Yi-lne/Embedded-project--DCDC_BUCK_and_BOOST/PCB/原理图与PCB/PCB_DCDC升降压_2026-11-07.png

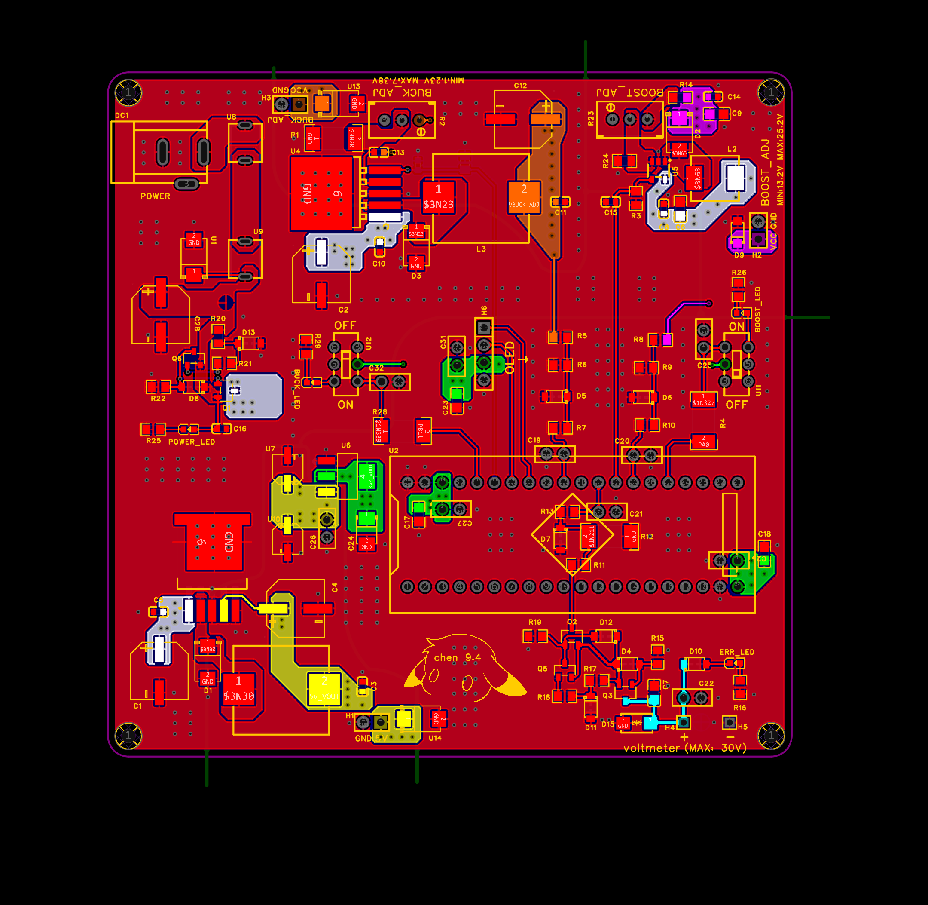
PCB/原理图与PCB/PCB_DCDC升降压_2026-11-07.png
