Yi-lne/Embedded-project--DCDC_BUCK_and_BOOST/PCB/原理图与PCB/SCH_Schematic1_1-升降压模块_2026-11-07.png

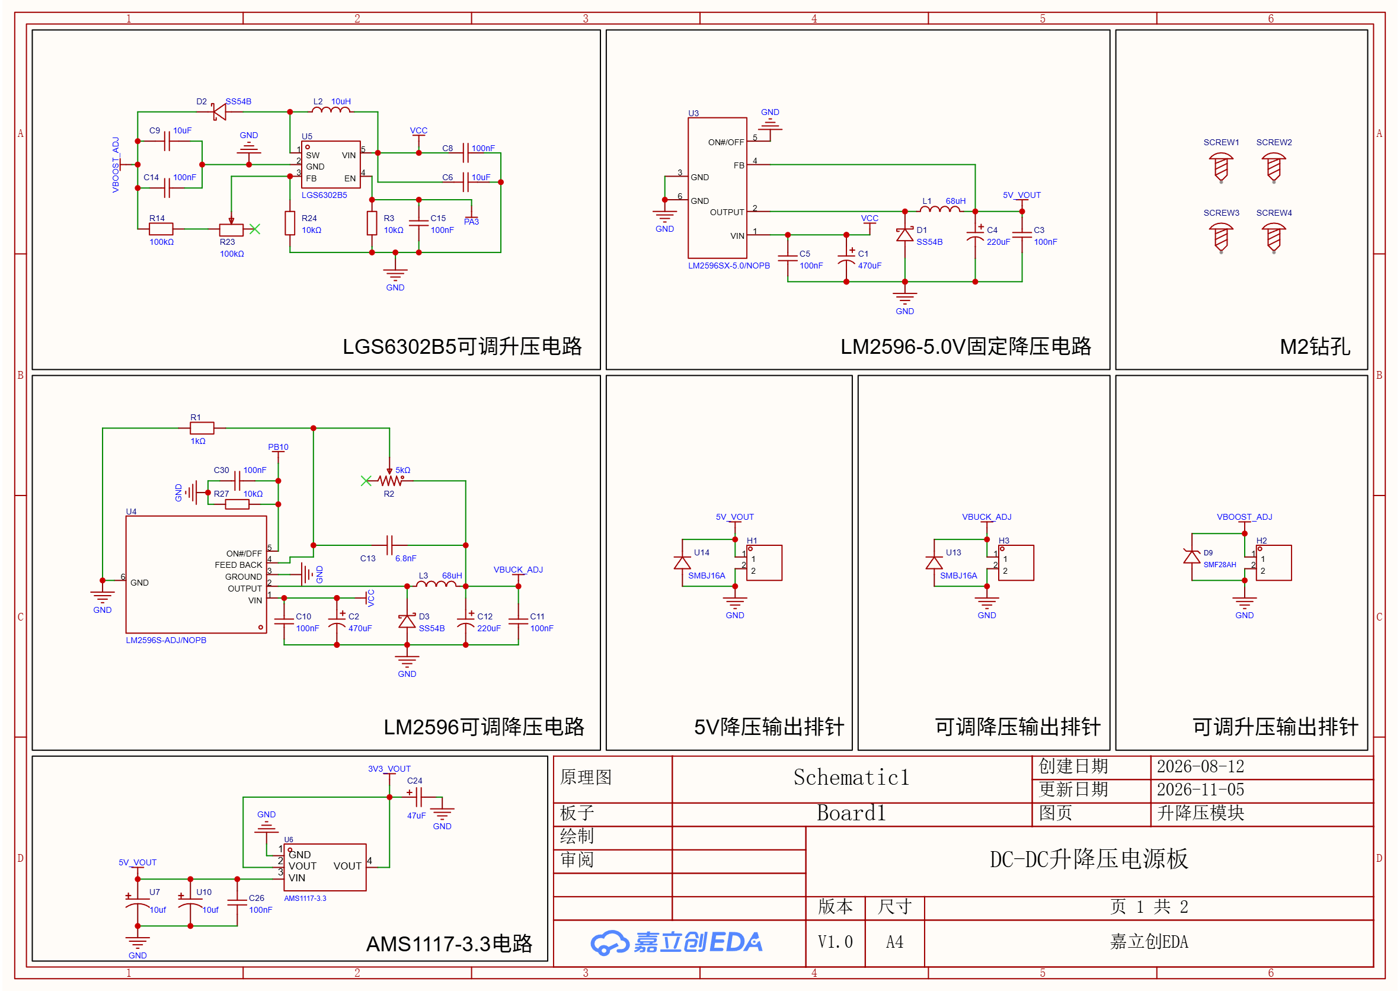
PCB/原理图与PCB/SCH_Schematic1_1-升降压模块_2026-11-07.png
