Yi-lne/Embedded-project--DCDC_BUCK_and_BOOST/program/Core/Src/main.c

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
/* Includes ------------------------------------------------------------------*/
#include "main.h"
#include "adc.h"
#include "dma.h"
#include "tim.h"
#include "gpio.h"

/* USER CODE BEGIN Includes */
#include "oled.h"
#include "switches.h"
#include "oled_show.h"
/* USER CODE END Includes */


/* USER CODE BEGIN PV */
//adc_data[0]: buck_adj, adc_data[1]: boost_adj, adc_data[2]: voltmeter
volatile uint16_t adc_data[3] = {0};
/* USER CODE END PV */

void SystemClock_Config(void);
/**
  * @brief  The application entry point.
  * @retval int
  */
int main(void)
{

  /* MCU Configuration--------------------------------------------------------*/

  /* Reset of all peripherals, Initializes the Flash interface and the Systick. */
  HAL_Init();

  /* Configure the system clock */
  SystemClock_Config();

  /* Initialize all configured peripherals */
  MX_GPIO_Init();
  MX_DMA_Init();
  MX_TIM3_Init();
  MX_TIM2_Init();
  MX_ADC1_Init();
  /* USER CODE BEGIN 2 */
  HAL_ADCEx_Calibration_Start(&hadc1);
  OLED_Init();
  OLED_ShowString(1, 1, "DCDC_BUCK_BOOST");
  OLED_ShowString(2, 1, "BUCK_ADJ :");
  OLED_ShowString(3, 1, "BOOST_ADJ:");
  OLED_ShowString(4, 1, "Voltmeter:");

  HAL_ADC_Start_DMA(&hadc1, (uint32_t*)adc_data, 3);
  /* 不使用 DMA 传输完成回调，关闭 TC 中断，避免 48kHz 中断持续打断软件 I2C */
  __HAL_DMA_DISABLE_IT(hadc1.DMA_Handle, DMA_IT_TC);

  switches_state_init();
  /* USER CODE END 2 */

  /* Infinite loop */
  /* USER CODE BEGIN WHILE */
  uint32_t last_refresh = HAL_GetTick();

  while (1)
  {
      if ((HAL_GetTick() - last_refresh) >= 100U)
      {
          last_refresh += 100U;
          //电压转换
          voltage_conversion();
          //电压显示
          voltage_display();
      }

      __WFI();

    /* USER CODE END WHILE */

    /* USER CODE BEGIN 3 */
  }
  /* USER CODE END 3 */
}

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
