Yi-lne/Embedded-project--DCDC_BUCK_and_BOOST/program/Core/Inc/main.h

#define BOOST_ADJ_SWITCH_Pin GPIO_PIN_0
#define BOOST_ADJ_SWITCH_GPIO_Port GPIOA
#define BOOST_ADJ_SWITCH_EXTI_IRQn EXTI0_IRQn
#define BOOST_ADJ_ADC_Pin GPIO_PIN_2
#define BOOST_ADJ_ADC_GPIO_Port GPIOA
#define BOOST_ADJ_DRIVER_Pin GPIO_PIN_3
#define BOOST_ADJ_DRIVER_GPIO_Port GPIOA
#define VOLTMETER_ADC_Pin GPIO_PIN_4
#define VOLTMETER_ADC_GPIO_Port GPIOA
#define BUCK_ADJ_ADC_Pin GPIO_PIN_6
#define BUCK_ADJ_ADC_GPIO_Port GPIOA
#define BUCK_ADJ_DRIVER_Pin GPIO_PIN_10
#define BUCK_ADJ_DRIVER_GPIO_Port GPIOB
#define BUCK_ADJ_SWITCH_Pin GPIO_PIN_11
#define BUCK_ADJ_SWITCH_GPIO_Port GPIOB
#define BUCK_ADJ_SWITCH_EXTI_IRQn EXTI15_10_IRQn
