Yi-lne/Embedded-project--DCDC_BUCK_and_BOOST/program/Hardware/oled/oled.c

#include "stm32f1xx_hal.h"
#include "OLED_Font.h"

/* 引脚配置：替换为HAL库的引脚操作宏 */
#define OLED_W_SCL(x)    HAL_GPIO_WritePin(GPIOB, GPIO_PIN_1, (GPIO_PinState)x)
#define OLED_W_SDA(x)    HAL_GPIO_WritePin(GPIOB, GPIO_PIN_0, (GPIO_PinState)x)

/* 软件 I2C 半周期延时。SSD1306 上限 400kHz，半周期约 1.25us。
 * -O0 下 12 次空循环约 1us 左右；用示波器看 PB1(SCL)，过快/过慢时调整该值。 */
#define OLED_I2C_DELAY_LOOPS    12U

static void OLED_I2C_Delay(void)
{
    for (volatile uint32_t i = 0; i < OLED_I2C_DELAY_LOOPS; i++)
    {
        __NOP();
    }
}

/* 前置声明：OLED_WriteDataBuffer 重试时需要重新设置光标 */
void OLED_SetCursor(uint8_t Y, uint8_t X);

/* 引脚初始化：适配HAL库GPIO初始化 */
void OLED_I2C_Init(void)
{
    GPIO_InitTypeDef GPIO_InitStructure = {0};

    /* 使能GPIOB时钟（HAL库方式） */
    __HAL_RCC_GPIOB_CLK_ENABLE();

    /* 配置PB8、PB9为开漏输出 */
    GPIO_InitStructure.Pin = GPIO_PIN_1 | GPIO_PIN_0;
    GPIO_InitStructure.Mode = GPIO_MODE_OUTPUT_OD;  // 开漏输出（与标准库一致）
    GPIO_InitStructure.Pull = GPIO_PULLUP;          // 内部弱上拉，外部模块还有 4.7k 上拉
    GPIO_InitStructure.Speed = GPIO_SPEED_FREQ_HIGH;// 高速（对应50MHz）
    HAL_GPIO_Init(GPIOB, &GPIO_InitStructure);

    /* 初始电平置高 */
    OLED_W_SCL(1);
    OLED_W_SDA(1);
}

/**
  * @brief  I2C开始
  * @param  无
  * @retval 无
  */
void OLED_I2C_Start(void)
{
    OLED_W_SDA(1);
    OLED_I2C_Delay();
    OLED_W_SCL(1);
    OLED_I2C_Delay();
    OLED_W_SDA(0);
    OLED_I2C_Delay();
    OLED_W_SCL(0);
    OLED_I2C_Delay();
}

/**
  * @brief  I2C停止
  * @param  无
  * @retval 无
  */
void OLED_I2C_Stop(void)
{
    OLED_W_SDA(0);
    OLED_I2C_Delay();
    OLED_W_SCL(1);
    OLED_I2C_Delay();
    OLED_W_SDA(1);
    OLED_I2C_Delay();
}

/**
  * @brief  I2C发送一个字节并读取应答
  * @param  Byte 要发送的一个字节
  * @retval 1：收到 ACK；0：收到 NACK
  */
uint8_t OLED_I2C_SendByte(uint8_t Byte)
{
    uint8_t i;
    uint8_t ack;

    for (i = 0; i < 8; i++)
    {
        OLED_W_SDA(!!(Byte & (0x80 >> i)));
        OLED_I2C_Delay();
        OLED_W_SCL(1);
        OLED_I2C_Delay();
        OLED_W_SCL(0);
        OLED_I2C_Delay();
    }

    /* 第 9 个时钟：释放 SDA，读取从机应答 */
    OLED_W_SDA(1);
    OLED_I2C_Delay();
    OLED_W_SCL(1);
    OLED_I2C_Delay();

    ack = (HAL_GPIO_ReadPin(GPIOB, GPIO_PIN_0) == GPIO_PIN_RESET) ? 1U : 0U;

    OLED_W_SCL(0);
    OLED_I2C_Delay();

    return ack;
}

/**
  * @brief  OLED写命令
  * @param  Command 要写入的命令
  * @retval 无
  */
void OLED_WriteCommand(uint8_t Command)
{
    uint8_t retry;

    for (retry = 0; retry < 3U; retry++)
    {
        OLED_I2C_Start();
        if (OLED_I2C_SendByte(0x78) &&       //从机地址
            OLED_I2C_SendByte(0x00) &&       //写命令
            OLED_I2C_SendByte(Command))
        {
            OLED_I2C_Stop();
            return;
        }
        OLED_I2C_Stop();
        OLED_I2C_Delay();
    }
}

/**
  * @brief  OLED写数据
  * @param  Data 要写入的数据
  * @retval 无
  */
void OLED_WriteData(uint8_t Data)
{
    uint8_t retry;

    for (retry = 0; retry < 3U; retry++)
    {
        OLED_I2C_Start();
        if (OLED_I2C_SendByte(0x78) &&       //从机地址
            OLED_I2C_SendByte(0x40) &&       //写数据
            OLED_I2C_SendByte(Data))
        {
            OLED_I2C_Stop();
            return;
        }
        OLED_I2C_Stop();
        OLED_I2C_Delay();
    }
}

/**
  * @brief  OLED连续写多个数据字节（一次 Start/Stop，减少事务开销）
  * @param  Y 页地址，范围：0~7
  * @param  X 列地址，范围：0~127
  * @param  Data 数据缓冲区
  * @param  Length 数据长度
  * @retval 无
  * @note   每次重试都会重新设置光标，避免半包写入后光标错位
  */
static void OLED_WriteDataBuffer(uint8_t Y, uint8_t X, const uint8_t *Data, uint8_t Length)
{
    uint8_t retry;

    for (retry = 0; retry < 3U; retry++)
    {
        uint8_t i;
        uint8_t ok = 1U;

        OLED_SetCursor(Y, X);
        OLED_I2C_Start();
        if (!OLED_I2C_SendByte(0x78) || !OLED_I2C_SendByte(0x40))
        {
            ok = 0U;
        }
        else
        {
            for (i = 0; i < Length; i++)
            {
                if (!OLED_I2C_SendByte(Data[i]))
                {
                    ok = 0U;
                    break;
                }
            }
        }
        OLED_I2C_Stop();

        if (ok)
        {
            return;
        }
        OLED_I2C_Delay();
    }
}

/**
  * @brief  OLED设置光标位置
  * @param  Y 以左上角为原点，向下方向的坐标，范围：0~7
  * @param  X 以左上角为原点，向右方向的坐标，范围：0~127
  * @retval 无
  */
void OLED_SetCursor(uint8_t Y, uint8_t X)
{
    OLED_WriteCommand(0xB0 | Y);                    //设置Y位置
    OLED_WriteCommand(0x10 | ((X & 0xF0) >> 4));    //设置X位置高4位
    OLED_WriteCommand(0x00 | (X & 0x0F));            //设置X位置低4位
}

/**
  * @brief  OLED清屏
  * @param  无
  * @retval 无
  */
void OLED_Clear(void)
{
    uint8_t i, j;
    uint8_t zero[16] = {0};

    for (j = 0; j < 8; j++)
    {
        for (i = 0; i < 8; i++)
        {
            OLED_WriteDataBuffer(j, (uint8_t)(i * 16U), zero, 16U);
        }
    }
}

/**
  * @brief  OLED显示一个字符
  * @param  Line 行位置，范围：1~4
  * @param  Column 列位置，范围：1~16
  * @param  Char 要显示的一个字符，范围：ASCII可见字符
  * @retval 无
  */
void OLED_ShowChar(uint8_t Line, uint8_t Column, uint8_t Char)
{
    uint8_t i;
    uint8_t buf[8];

    for (i = 0; i < 8; i++)
    {
        buf[i] = OLED_F8x16[Char - ' '][i];                  //上半部分内容
    }
    OLED_WriteDataBuffer((uint8_t)((Line - 1) * 2), (uint8_t)((Column - 1) * 8), buf, 8U);

    for (i = 0; i < 8; i++)
    {
        buf[i] = OLED_F8x16[Char - ' '][i + 8];              //下半部分内容
    }
    OLED_WriteDataBuffer((uint8_t)((Line - 1) * 2 + 1), (uint8_t)((Column - 1) * 8), buf, 8U);
}

/**
  * @brief  OLED显示字符串
  * @param  Line 起始行位置，范围：1~4
  * @param  Column 起始列位置，范围：1~16
  * @param  String 要显示的字符串，范围：ASCII可见字符
  * @retval 无
  */
void OLED_ShowString(uint8_t Line, uint8_t Column, const char String[])
{
    uint8_t i;
    for (i = 0; String[i] != '\0'; i++)
    {
        OLED_ShowChar(Line, Column + i, (uint8_t)String[i]);
    }
}

/**
  * @brief  OLED次方函数
  * @retval 返回值等于X的Y次方
  */
uint32_t OLED_Pow(uint32_t X, uint32_t Y)
{
    uint32_t Result = 1;
    while (Y--)
    {
        Result *= X;
    }
    return Result;
}

/**
  * @brief  OLED显示数字（十进制，正数）
  * @param  Line 起始行位置，范围：1~4
  * @param  Column 起始列位置，范围：1~16
  * @param  Number 要显示的数字，范围：0~4294967295
  * @param  Length 要显示数字的长度，范围：1~10
  * @retval 无
  */
void OLED_ShowNum(uint8_t Line, uint8_t Column, uint32_t Number, uint8_t Length)
{
    uint8_t i;
    for (i = 0; i < Length; i++)
    {
        OLED_ShowChar(Line, Column + i, Number / OLED_Pow(10, Length - i - 1) % 10 + '0');
    }
}

/**
  * @brief  OLED显示数字（十进制，带符号数）
  * @param  Line 起始行位置，范围：1~4
  * @param  Column 起始列位置，范围：1~16
  * @param  Number 要显示的数字，范围：-2147483648~2147483647
  * @param  Length 要显示数字的长度，范围：1~10
  * @retval 无
  */
void OLED_ShowSignedNum(uint8_t Line, uint8_t Column, int32_t Number, uint8_t Length)
{
    uint8_t i;
    uint32_t Number1;
    if (Number >= 0)
    {
        OLED_ShowChar(Line, Column, '+');
        Number1 = Number;
    }
    else
    {
        OLED_ShowChar(Line, Column, '-');
        Number1 = -Number;
    }
    for (i = 0; i < Length; i++)
    {
        OLED_ShowChar(Line, Column + i + 1, Number1 / OLED_Pow(10, Length - i - 1) % 10 + '0');
    }
}

/**
  * @brief  OLED显示数字（十六进制，正数）
  * @param  Line 起始行位置，范围：1~4
  * @param  Column 起始列位置，范围：1~16
  * @param  Number 要显示的数字，范围：0~0xFFFFFFFF
  * @param  Length 要显示数字的长度，范围：1~8
  * @retval 无
  */
void OLED_ShowHexNum(uint8_t Line, uint8_t Column, uint32_t Number, uint8_t Length)
{
    uint8_t i, SingleNumber;
    for (i = 0; i < Length; i++)
    {
        SingleNumber = Number / OLED_Pow(16, Length - i - 1) % 16;
        if (SingleNumber < 10)
        {
            OLED_ShowChar(Line, Column + i, SingleNumber + '0');
        }
        else
        {
            OLED_ShowChar(Line, Column + i, SingleNumber - 10 + 'A');
        }
    }
}

/**
  * @brief  OLED显示数字（二进制，正数）
  * @param  Line 起始行位置，范围：1~4
  * @param  Column 起始列位置，范围：1~16
  * @param  Number 要显示的数字，范围：0~1111 1111 1111 1111
  * @param  Length 要显示数字的长度，范围：1~16
  * @retval 无
  */
void OLED_ShowBinNum(uint8_t Line, uint8_t Column, uint32_t Number, uint8_t Length)
{
    uint8_t i;
    for (i = 0; i < Length; i++)
    {
        OLED_ShowChar(Line, Column + i, Number / OLED_Pow(2, Length - i - 1) % 2 + '0');
    }
}

/**
  * @brief  OLED初始化
  * @param  无
  * @retval 无
  */
void OLED_Init(void)
{
    /* 上电延时：替换为HAL库延时（ms级，更精准） */
    HAL_Delay(100);  // 替代原嵌套循环，延时100ms足够完成上电稳定

    OLED_I2C_Init();        //端口初始化

    OLED_WriteCommand(0xAE); //关闭显示

    OLED_WriteCommand(0xD5); //设置显示时钟分频比/振荡器频率
    OLED_WriteCommand(0x80);

    OLED_WriteCommand(0xA8); //设置多路复用率
    OLED_WriteCommand(0x3F);

    OLED_WriteCommand(0xD3); //设置显示偏移
    OLED_WriteCommand(0x00);

    OLED_WriteCommand(0x40); //设置显示开始行

    OLED_WriteCommand(0xA1); //设置左右方向，0xA1正常 0xA0左右反置

    OLED_WriteCommand(0xC8); //设置上下方向，0xC8正常 0xC0上下反置

    OLED_WriteCommand(0xDA); //设置COM引脚硬件配置
    OLED_WriteCommand(0x12);

    OLED_WriteCommand(0x81); //设置对比度控制
    OLED_WriteCommand(0xCF);

    OLED_WriteCommand(0xD9); //设置预充电周期
    OLED_WriteCommand(0xF1);

    OLED_WriteCommand(0xDB); //设置VCOMH取消选择级别
    OLED_WriteCommand(0x30);

    OLED_WriteCommand(0xA4); //设置整个显示打开/关闭

    OLED_WriteCommand(0xA6); //设置正常/倒转显示

    OLED_WriteCommand(0x8D); //设置充电泵
    OLED_WriteCommand(0x14);

    OLED_WriteCommand(0xAF); //开启显示

    OLED_Clear();            //OLED清屏
}
