Yi-lne/Embedded-project--DCDC_BUCK_and_BOOST/(commit log)

2026-11-11 v1.1 --用宏定义替换了魔法数字，更正了错误标签
2026-11-11 更新电压换算系数，ADC码值加入低通滤波，对电压四舍五入，降低OLED刷新频率等
