Yi-lne/Embedded-project--DCDC_BUCK_and_BOOST/(notices)

Notices in the files:
program/Core/Src/tim.c:
Copyright (c) 2026 STMicroelectronics.
All rights reserved.
This software is licensed under terms that can be found in the LICENSE file
